Freimor/HRDW-StaircaseLightController/README.md

# HRDW-StaircaseLightController
A modular staircase LED light controller based on Raspberry Pico
