Freimor/HRDW-StaircaseLightController/KiCad/StaircaseLight_controller_v1/StaircaseLight_controller.kicad_pcb

## KiCad design KiCad/StaircaseLight_controller_v1/StaircaseLight_controller.kicad_pcb (2026-04-22)

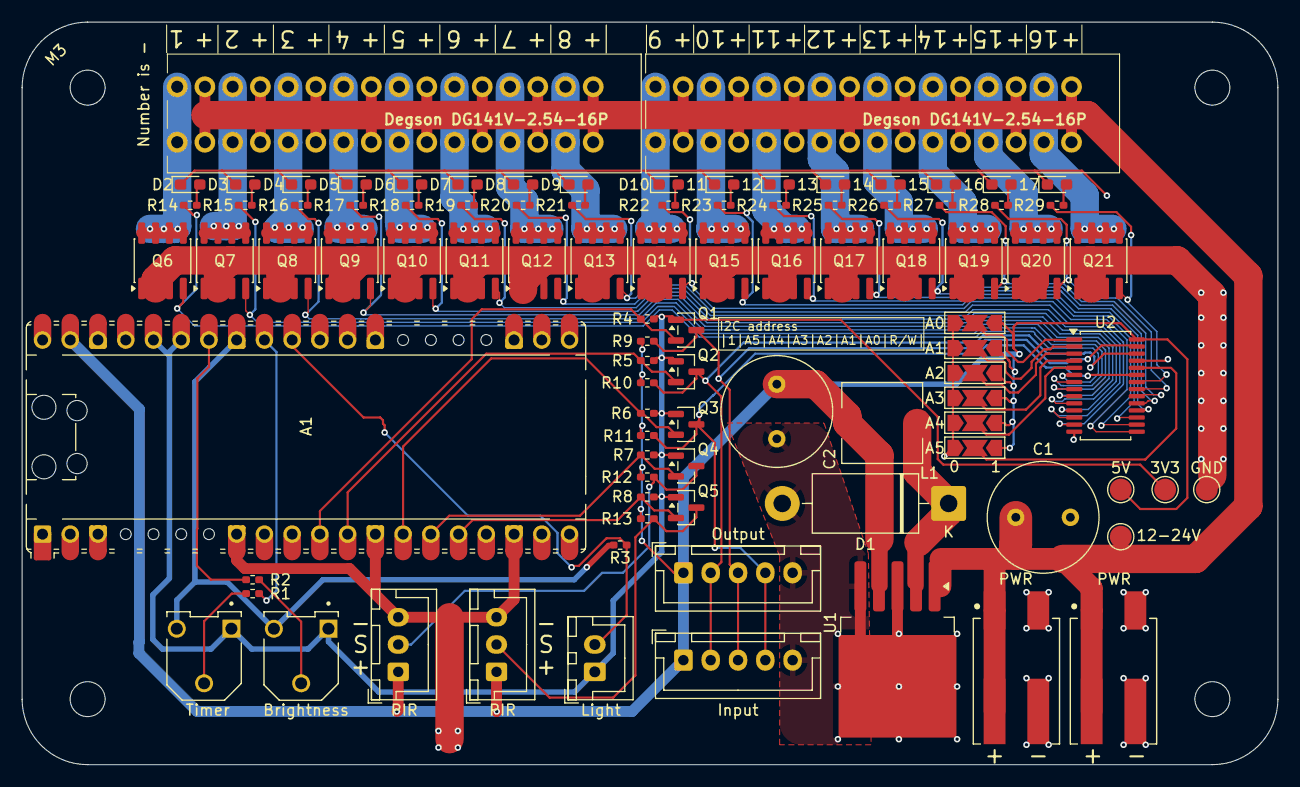
[picture p1: board StaircaseLight_controller.kicad_pcb from above]

Board: 2 copper layers, 115.0 x 68.0 mm, 95 parts (0 on the bottom side), 75 nets.

Parts:
3V3: 3v3; TestPoint_Pad_D2.0mm
5V: 5v; TestPoint_Pad_D2.0mm
11, 12, 13, 14, 15, 16, 17: LED; LED_0603_1608Metric_Pad1.05x0.95mm_HandSolder
12-24V: VDD; TestPoint_Pad_D2.0mm
A1: RaspberryPi_Pico; RaspberryPi_Pico_Common_Unspecified
Brightness: POT_Brightness; POT_BOURNS_3306F
C1: 330uF 50v; C_Radial_D10.0mm_H16.0mm_P5.00mm
C2: 220uF 10v; C_Radial_D10.0mm_H12.5mm_P5.00mm
D1: 1N5822; D_DO-201AD_P15.24mm_Horizontal
D2, D3, D4, D5, D6, D7, D8, D9, D10: LED; LED_0603_1608Metric_Pad1.05x0.95mm_HandSolder
GND: GND; TestPoint_Pad_D2.0mm
Input: BOARD_IN; JST_XH_B5B-XH-A_1x05_P2.50mm_Vertical
J4: ROW1; Conn_Degson_DG141V-2.54-16P
J6: ROW2; Conn_Degson_DG141V-2.54-16P
JP1: ADD_5; SolderJumper-3_P2.0mm_Open_TrianglePad1.0x1.5mm_NumberLabels
JP2: ADD_4; SolderJumper-3_P2.0mm_Open_TrianglePad1.0x1.5mm_NumberLabels
JP3: ADD_3; SolderJumper-3_P2.0mm_Open_TrianglePad1.0x1.5mm_NumberLabels
JP4: ADD_2; SolderJumper-3_P2.0mm_Open_TrianglePad1.0x1.5mm_NumberLabels
JP5: ADD_1; SolderJumper-3_P2.0mm_Open_TrianglePad1.0x1.5mm_NumberLabels
JP6: ADD_0; SolderJumper-3_P2.0mm_Open_TrianglePad1.0x1.5mm_NumberLabels
L1: 47uH (or 100uH from graph); L_7.3x7.3_H4.5
Light: Photo; JST_XH_B2B-XH-A_1x02_P2.50mm_Vertical
M3: MountingHole_3.2mm_M3
Output: BOARD_OUT; JST_XH_B5B-XH-A_1x05_P2.50mm_Vertical
PIR: PIR_2_conn; JST_XH_B3B-XH-A_1x03_P2.50mm_Vertical
PIR#2: PIR_1_conn; JST_XH_B3B-XH-A_1x03_P2.50mm_Vertical
PWR: PWR_IN; Conn_WAGO_2060-402
PWR#2: PWR_SLV; Conn_WAGO_2060-402
Q1, Q2, Q3, Q4, Q5: BSS138 (or AO3400); SOT-23
Q6, Q7, Q8, Q9, Q10, Q11, Q12, Q13, Q14, Q15, Q16, Q17, Q18, Q19, Q20, Q21: AO4466; SOP-8_3.76x4.96mm_P1.27mm
R1, R2, R14, R15, R16, R17, R18, R19, R20, R21, R22, R23, R24, R25, R26, R27, R28, R29: 1k; R_0402_1005Metric_Pad0.72x0.64mm_HandSolder
R3, R11, R12, R13: 10k; R_0402_1005Metric_Pad0.72x0.64mm_HandSolder
R4, R5: 1.8K; R_0402_1005Metric_Pad0.72x0.64mm_HandSolder
R6, R7, R8: 10K; R_0402_1005Metric_Pad0.72x0.64mm_HandSolder
R9, R10: 1.8k; R_0402_1005Metric_Pad0.72x0.64mm_HandSolder
Timer: POT_Timer; POT_BOURNS_3306F
U1: LM2575-5.0BU; TO-263-5_TabPin3
U2: PCA9685PW; TSSOP-28_4.4x9.7mm_P0.65mm

Connections:
12-24V: 12-24V.1, C1.1, J4.2, J4.4, J4.6, J4.8, J4.10, J4.12, J4.14, J4.16, J6.2, J6.4, J6.6, J6.8, J6.10, J6.12, J6.14, J6.16, PWR.1, PWR#2.1, U1.1 (VIN)
+3.3V: 3V3.1, A1.35 (ADC_VREF), A1.36 (3V3), Brightness.1, Light.1, Q1.1 (G), Q2.1 (G), Q3.1 (G), Q4.1 (G), Q5.1 (G), R4.2, R5.2, R6.2, R7.2, R8.2, Timer.1
+5V: 5V.1, A1.39 (VSYS), C2.1, Input.1, JP1.3 (B), JP2.3 (B), JP3.3 (B), JP4.3 (B), JP5.3 (B), JP6.3 (B), L1.2, Output.1, PIR.1, PIR#2.1, R9.2, R10.2, R11.2, R12.2, R13.2, U1.4 (FB), U2.28 (VDD)
GND: 11.1 (K), 12.1 (K), 13.1 (K), 14.1 (K), 15.1 (K), 16.1 (K), 17.1 (K), A1.3 (GND), A1.8 (GND), A1.13 (GND), A1.18 (GND), A1.23 (GND), A1.28 (GND), A1.38 (GND), C1.2, C2.2, D1.2 (A), D2.1 (K), D3.1 (K), D4.1 (K), D5.1 (K), D6.1 (K), D7.1 (K), D8.1 (K), D9.1 (K), D10.1 (K), GND.1, Input.5, JP1.1 (A), JP2.1 (A), JP3.1 (A), JP4.1 (A), JP5.1 (A), JP6.1 (A), Output.5, PIR.3, PIR#2.3, PWR.2, PWR#2.2, Q6.1 (S), Q6.2 (S), Q6.3 (S), Q7.1 (S), Q7.2 (S), Q7.3 (S), Q8.1 (S), Q8.2 (S), Q8.3 (S), Q9.1 (S), Q9.2 (S), Q9.3 (S), Q10.1 (S), Q10.2 (S), Q10.3 (S), Q11.1 (S), Q11.2 (S), Q11.3 (S), Q12.1 (S), Q12.2 (S), Q12.3 (S), Q13.1 (S), Q13.2 (S), Q13.3 (S), Q14.1 (S), Q14.2 (S), Q14.3 (S), Q15.1 (S), Q15.2 (S), Q15.3 (S), Q16.1 (S), Q16.2 (S), Q16.3 (S), Q17.1 (S), Q17.2 (S), Q17.3 (S), Q18.1 (S), Q18.2 (S), Q18.3 (S), Q19.1 (S), Q19.2 (S), Q19.3 (S), Q20.1 (S), Q20.2 (S), Q20.3 (S), Q21.1 (S), Q21.2 (S), Q21.3 (S), U1.3 (GND), U1.5 (~ON/OFF), U2.14 (VSS), U2.25 (EXTCLK)
GNDS: A1.33 (AGND), Brightness.3, R3.2, Timer.3
I2C_C_3v3: A1.12 (GPIO9), Q2.2 (S), R5.1
I2C_C_5v: Input.2, Output.2, Q2.3 (D), R10.1, U2.26 (SCL)
I2C_D_3v3: A1.11 (GPIO8), Q1.2 (S), R4.1
I2C_D_5v: Input.3, Output.3, Q1.3 (D), R9.1, U2.27 (SDA)
unnamed: A1.31 (GPIO26_ADC0), Light.2, R3.1
unnamed: A1.32 (GPIO27_ADC1), R1.1
unnamed: A1.34 (GPIO28_ADC2), R2.1
unnamed: D1.1 (K), L1.1, U1.2 (OUT)
unnamed: D2.2 (A), R14.2
unnamed: D3.2 (A), R15.2
unnamed: D4.2 (A), R16.2
unnamed: D5.2 (A), R17.2
unnamed: D6.2 (A), R18.2
unnamed: D7.2 (A), R19.2
unnamed: D8.2 (A), R20.2
unnamed: D9.2 (A), R21.2
unnamed: D10.2 (A), R22.2
unnamed: 11.2 (A), R23.2
unnamed: 12.2 (A), R24.2
unnamed: 13.2 (A), R25.2
unnamed: 14.2 (A), R26.2
unnamed: 15.2 (A), R27.2
unnamed: 16.2 (A), R28.2
unnamed: 17.2 (A), R29.2
unnamed: JP1.2 (C), U2.24 (A5)
unnamed: JP2.2 (C), U2.5 (A4)
unnamed: JP3.2 (C), U2.4 (A3)
unnamed: JP4.2 (C), U2.3 (A2)
unnamed: JP5.2 (C), U2.2 (A1)
unnamed: JP6.2 (C), U2.1 (A0)
unnamed: R1.2, Timer.2
unnamed: Brightness.2, R2.2
PCA9685_OE_3v3: A1.14 (GPIO10), Q3.2 (S), R6.1
PCA9685_OE_5v: Input.4, Output.4, Q3.3 (D), R11.1, U2.23 (~OE)
PIR_1_3v3: A1.15 (GPIO11), Q4.2 (S), R7.1
PIR_1_5v: PIR#2.2, Q4.3 (D), R12.1
PIR_2_3v3: A1.16 (GPIO12), Q5.2 (S), R8.1
PIR_2_5v: PIR.2, Q5.3 (D), R13.1
PORT1: J4.1, Q6.5 (D), Q6.6 (D), Q6.7 (D), Q6.8 (D)
PORT2: J4.3, Q7.5 (D), Q7.6 (D), Q7.7 (D), Q7.8 (D)
PORT3: J4.5, Q8.5 (D), Q8.6 (D), Q8.7 (D), Q8.8 (D)
PORT4: J4.7, Q9.5 (D), Q9.6 (D), Q9.7 (D), Q9.8 (D)
PORT5: J4.9, Q10.5 (D), Q10.6 (D), Q10.7 (D), Q10.8 (D)
PORT6: J4.11, Q11.5 (D), Q11.6 (D), Q11.7 (D), Q11.8 (D)
PORT7: J4.13, Q12.5 (D), Q12.6 (D), Q12.7 (D), Q12.8 (D)
PORT8: J4.15, Q13.5 (D), Q13.6 (D), Q13.7 (D), Q13.8 (D)
PORT9: J6.1, Q14.5 (D), Q14.6 (D), Q14.7 (D), Q14.8 (D)
PORT10: J6.3, Q15.5 (D), Q15.6 (D), Q15.7 (D), Q15.8 (D)
PORT11: J6.5, Q16.5 (D), Q16.6 (D), Q16.7 (D), Q16.8 (D)
PORT12: J6.7, Q17.5 (D), Q17.6 (D), Q17.7 (D), Q17.8 (D)
PORT13: J6.9, Q18.5 (D), Q18.6 (D), Q18.7 (D), Q18.8 (D)
PORT14: J6.11, Q19.5 (D), Q19.6 (D), Q19.7 (D), Q19.8 (D)
PORT15: J6.13, Q20.5 (D), Q20.6 (D), Q20.7 (D), Q20.8 (D)
PORT16: J6.15, Q21.5 (D), Q21.6 (D), Q21.7 (D), Q21.8 (D)
SW1: Q6.4 (G), R14.1, U2.6 (LED0)
SW2: Q7.4 (G), R15.1, U2.7 (LED1)
SW3: Q8.4 (G), R16.1, U2.8 (LED2)
SW4: Q9.4 (G), R17.1, U2.9 (LED3)
SW5: Q10.4 (G), R18.1, U2.10 (LED4)
SW6: Q11.4 (G), R19.1, U2.11 (LED5)
SW7: Q12.4 (G), R20.1, U2.12 (LED6)
SW8: Q13.4 (G), R21.1, U2.13 (LED7)
SW9: Q14.4 (G), R22.1, U2.15 (LED8)
SW10: Q15.4 (G), R23.1, U2.16 (LED9)
SW11: Q16.4 (G), R24.1, U2.17 (LED10)
SW12: Q17.4 (G), R25.1, U2.18 (LED11)
SW13: Q18.4 (G), R26.1, U2.19 (LED12)
SW14: Q19.4 (G), R27.1, U2.20 (LED13)
SW15: Q20.4 (G), R28.1, U2.21 (LED14)
SW16: Q21.4 (G), R29.1, U2.22 (LED15)
